sudhu-joshi/audio-amp/README.md

# Audio Amplifier Design
This is Project-1 of the EW-2 (EC2.202), Spring 2025. The design goes over theoretical calculation *(included in report)*, simulation and implementation of 4 stages:
# Stages
- Differential Amplifier
- CE Stage
- Active Bandpass Filter (20Hz-20kHz)
- Power Amplifier
# Report
All details related to the project are included in `amplifier_report`. Components used are included in the corresponding folder.
