sudhu-joshi/audio-amp/amp_report.pdf

# EW-2 Report Project 1: Audio Amplifier

Roshan Kondabattini
2023102061

Sudhanva Joshi
2023102022

10th January 2025

Note: All project files are saved in the github repository. (https://github.com/sudhu-joshi/audio-amp)

## Aim & Objectives

## 1 Differential Amplifier- Pre-Gain Stage

Considering we have a maximum input of 10 mV amplitude, with VCC = ±5V , we can get a maximum output voltage of 10 mV × 500 = 5V . Hence, we aim for a gain of 500. The stage gains must be split as follows:

- Given the information that the CE Amplifier works for small signals, we aim to pass a signal ≤ 100 mV .
- In order to amplify a 10 mV signal to 100 mV, we need a gain of 10 in the differential amplifier.

Basic Operation

- Amplifies the difference between two input signals Vin1 and Vin2.
- Comprises two matched BJTs (Q1 and Q2) sharing a common emitter via a constant current source.
- Output: Voltage difference between collector resistors (RC ).

Working Principle

- If Vin1 > Vin2: Q1 conducts more current, Q2 less. This creates a voltage difference at the collectors.
- If Vin2 > Vin1: Q2 conducts more current, Q1 less.
- If Vin1 = Vin2 (common-mode input): Both transistors share the current equally, resulting in no differential output.

Noise Cancellation

Noise often affects both inputs similarly as a common-mode signal. The differential amplifier rejects this common-mode noise. It responds only to the difference between the inputs, effectively canceling the noise and amplifying the difference.

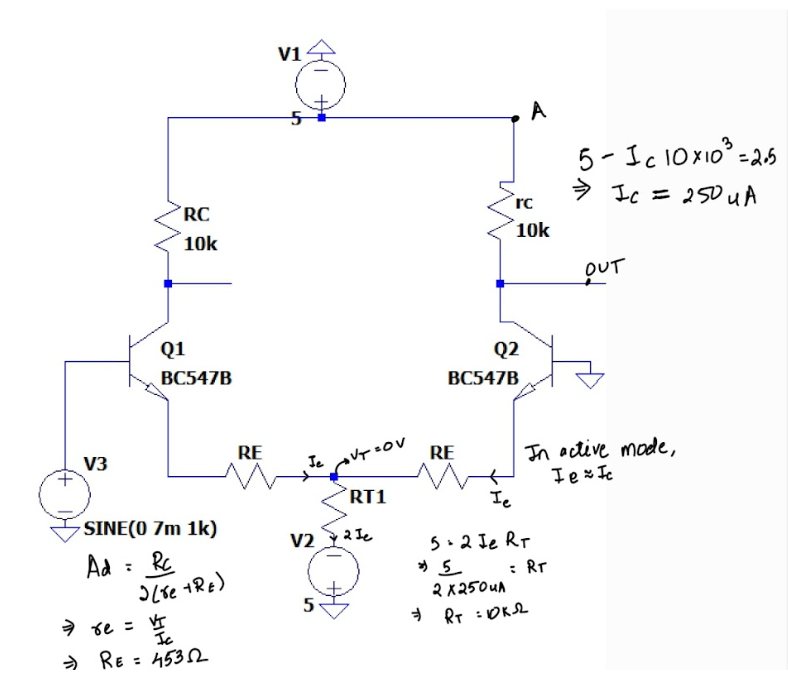
[picture p1: figure]

Figure 1: Rough Calculation, Differential Amplifier

Gain derivation of Differential Amplifier

iC1(AC + DC) = I
2

+ ∆ic

=

I
2

+ ic (AC)

=

I
2

+ gm (Vi2)

=

I
2

+ gm (−Vid)

=

I
2

−

gmVid
2

vout = VCC − IAC+DC RC (AC only taken)

= VCC −

I
2

RC +

gmVidRC
2

Vout (differential)

Vin

=

gmVidRC
2Vid

=

gmRC
2

Gain = RC
2(re + RE)

where an external Re is added with re.

Parameter Calculations

As we work with ±5 V, we make a few initial assumptions (these shall be substantiated by our calculations).
VT = 0V

IC ≈ IE (Active BJT s)

RC = 10k Ω

To calculate IC , we simplify the following Voltage Equation:

Vcc − R2 · IC = 2.5V

IC · 10k = (2.5 − 5) · (−1)

IC = 2.5 · 10⁻⁴

∴ IC = 250µA

As IC is symmetric between both Emitter Branches,

IT = 2 · IC

Using Ohm’s Law (V = I· R):
5 = 2 · IC

5 = 5 · 10⁻⁴
- Rtail

∴ Rtail = 10k Ω

To account for Non-Ideal Conditions, we assume a gain G1 = 11

Ad =

RC
2 · (re + RE)

Ad =

RC
2 · (re + RE)

re =

VT
IC
Substituting VT = 26mV & IC = 2.5 · 10⁻⁴ :

re = 104 Ω

Solving for RE:

11 =

10 · 10³
104 + RE
∴ RE = 453 Ω

To account for our assumption of G1 = 11, RE = 453 Ω is considered as a starting value, after which it is lowered until the appropriate gain is achieved.
In conclusion, we arrive at R = 354 Ω for the desired gain specification, i.e. G1 ≈ 10.

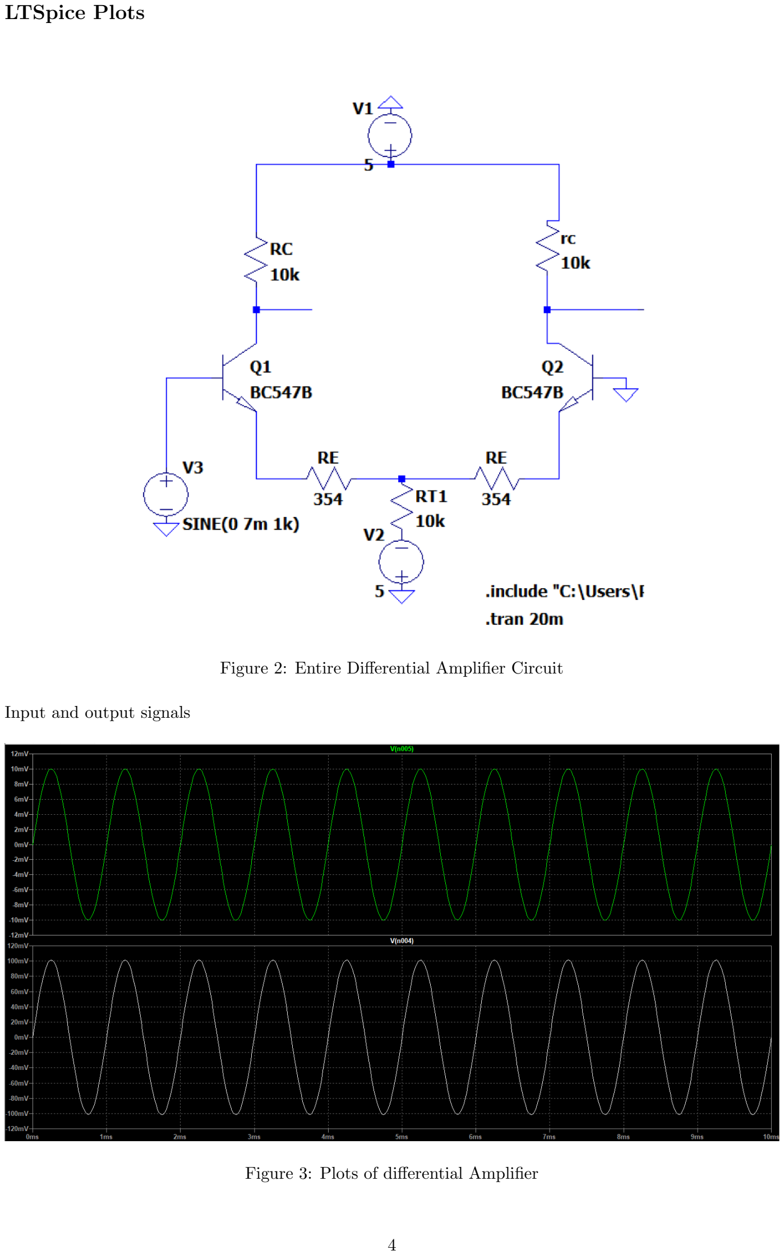
[picture p2: page 4]

LTSpice Plots

Figure 2: Entire Differential Amplifier Circuit

Input and output signals

Figure 3: Plots of differential Amplifier

CMRR, Input & Output Resistances

- Common Mode Rejection Ratio is the ability of a differential amplifier to reject common-mode signals (signals present equally on both inputs) while amplifying differential signals (difference between inputs).
- High CMRR indicates better noise rejection and improved signal fidelity.

CMRR = 20 · log(

Ad
Ac

)

Calculating AC , we give 10mV to both BJTs of our differential amplifier, we get the following gain:

Ac = 0.5

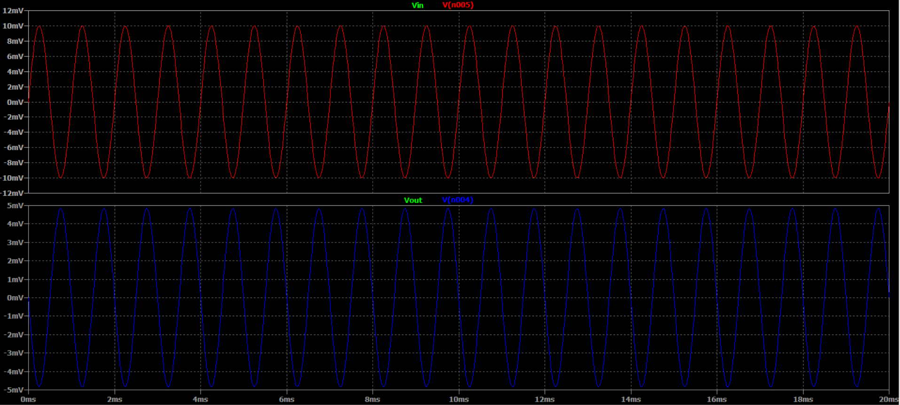
[picture p3: figure]

Figure 4: AC Relation; Vin & Vout

Substituting Gains to get CMRR:

CMRR = 20 · log(

10
0.5

)

∴ CMRR ≈ 26

Input Resistance Grounding output and giving VDC = 1V , we get current of 57µ A. Rin = 17543 Ω.

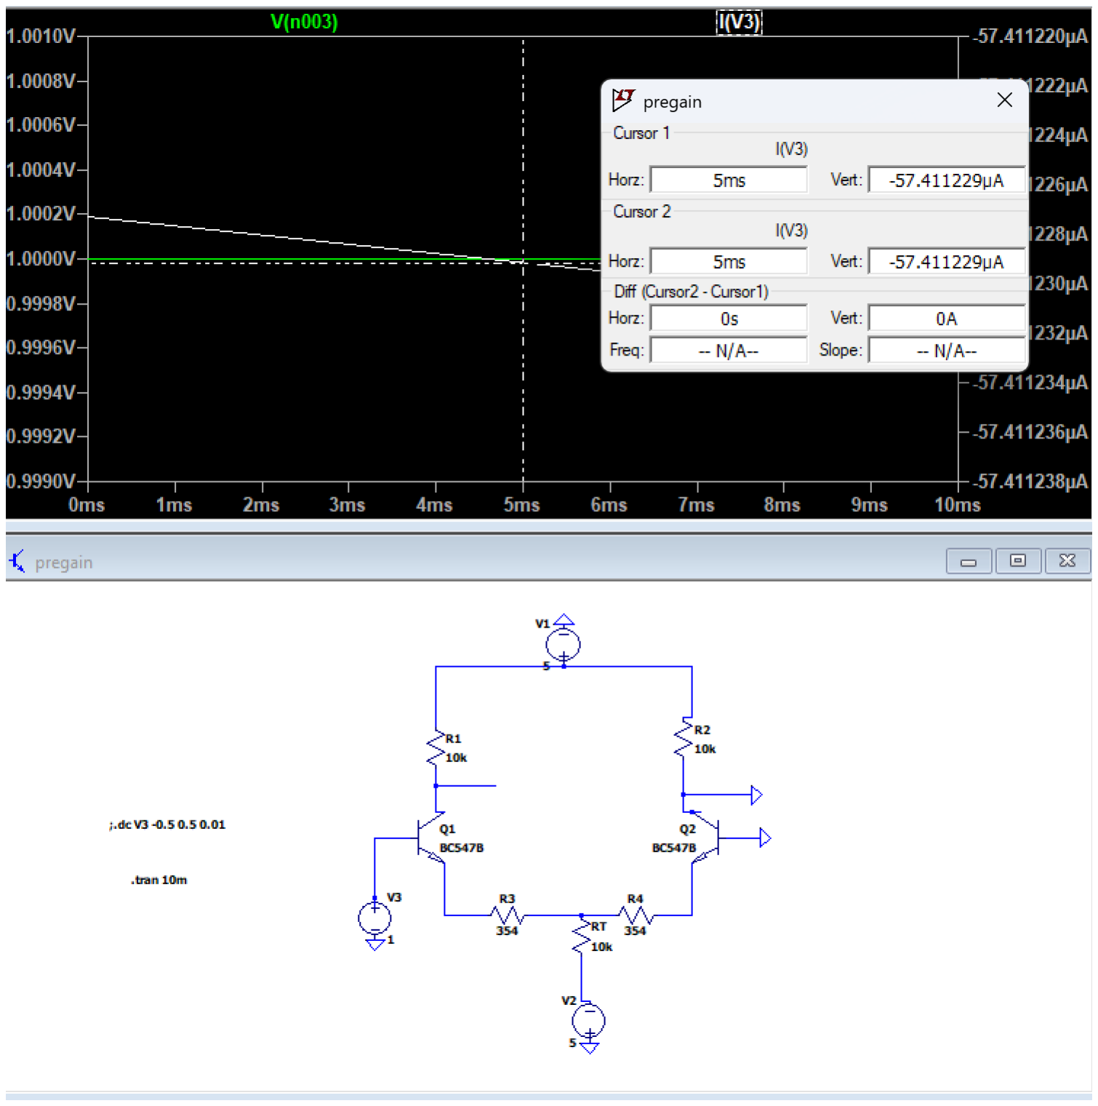
[picture p4: figure]

Figure 5: Rin

Output resistance We give output voltage 1V, and ground the input, we have resistance of 5kΩ.

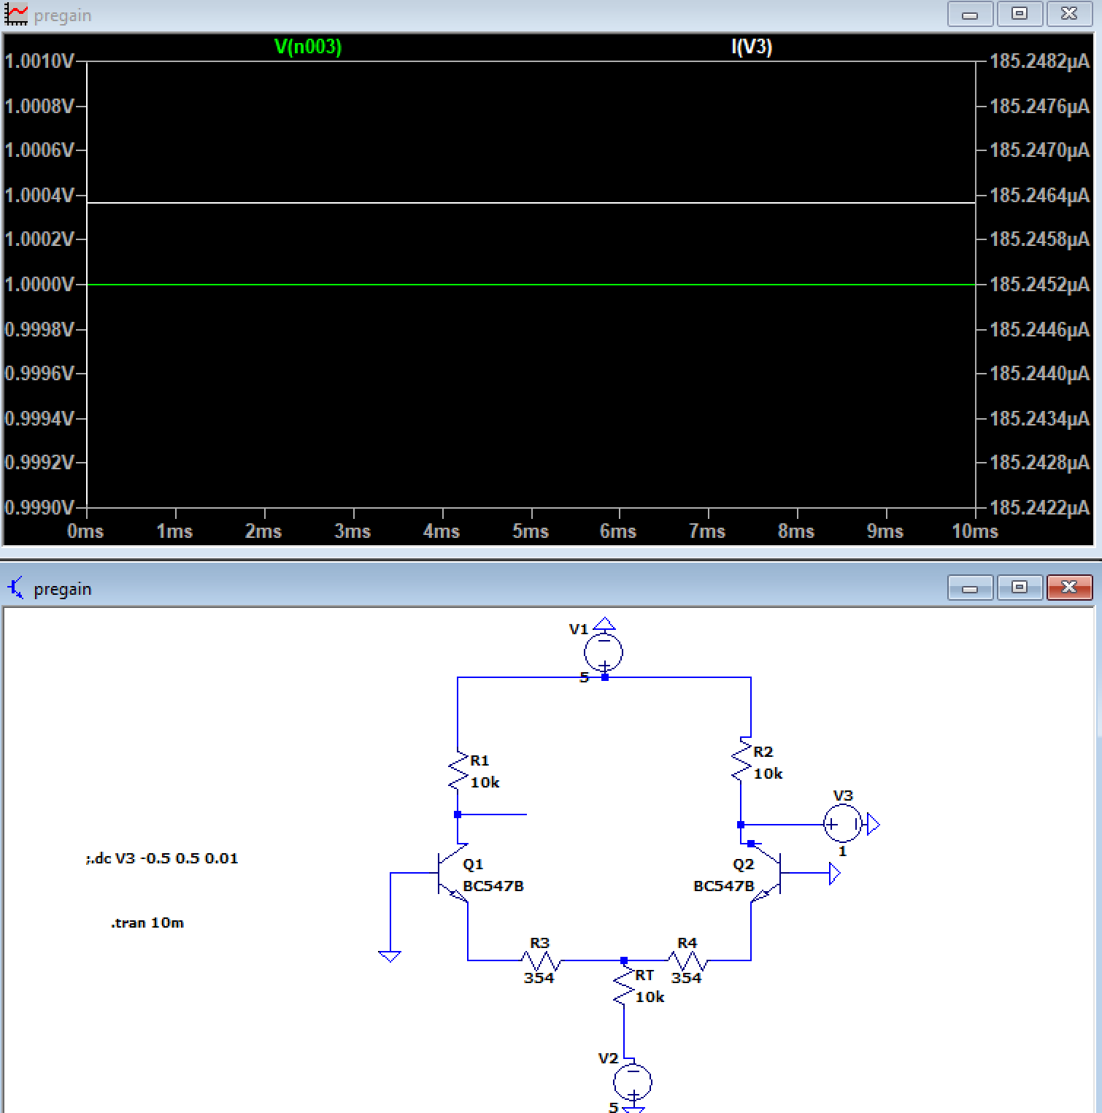
[picture p5: figure]

Figure 6: Ouput Resistance

## 2 Common Emitter (CE) Amplifier

- Purpose: Provides voltage amplification with phase inversion.
- Configuration: Input is applied at the base, output is taken from the collector, and the emitter is connected to ground through a resistor.
- Key Features: High voltage gain, moderate input impedance, low output impedance, and an inverted output signal.
- Working Principle:

– Small increases in base-emitter voltage (VBE) (a few mV) significantly increase base current (IB).

– Current gain (β) amplifies IB, causing larger changes in collector current (IC ).

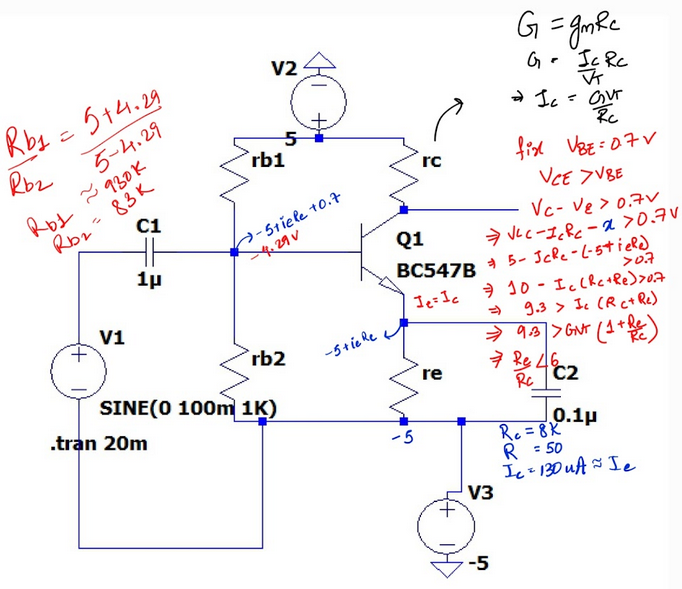
[picture p6: figure]

Figure 7: Parameter Calculations, CE Amplifier

Gain derviation of CE amplifier

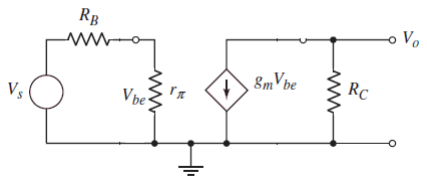
[picture p7: figure]

Figure 8: Small signal model of CE amplifer

form the above figure, We start with Ohm’s Law:

V = IR

For the output voltage:

Vout = gmVbe(RC ∥ RL)

The voltage gain is given by:

Vout

Vin

= gmRC

where we assume RL = 0.

Parameter Calculations

For a CE amplifier,we fix G=60 and calculate the values.

G = gm · RC

gm =

IC
VT

IC =

G · VT
RC

F ixing VBE = 0.7V

VC − VE > 0.7V

VCC − IC · RC − x > 0.7V

W here x = −5 + IE · RE

10 − IC · (RC + RE) > 0.7V

∴ G · VT (1 + RE
RC

) < 9.3

Substituting values, we get: RE
RC

< 6

To ensure active BJTs, we calculate Rb1 & Rb2 using Current Law as follows, with VB = −4.29V

Rb1

Rb2

=

5 + 4.29
5 − 4.29

∴ Rb1 ≈ 930k Ω, Rb2 ≈ 78k Ω

Our final values are:
RC = 8k Ω

R = 50 Ω

IC ≈ IE = 130 µA

LTSpice Plots

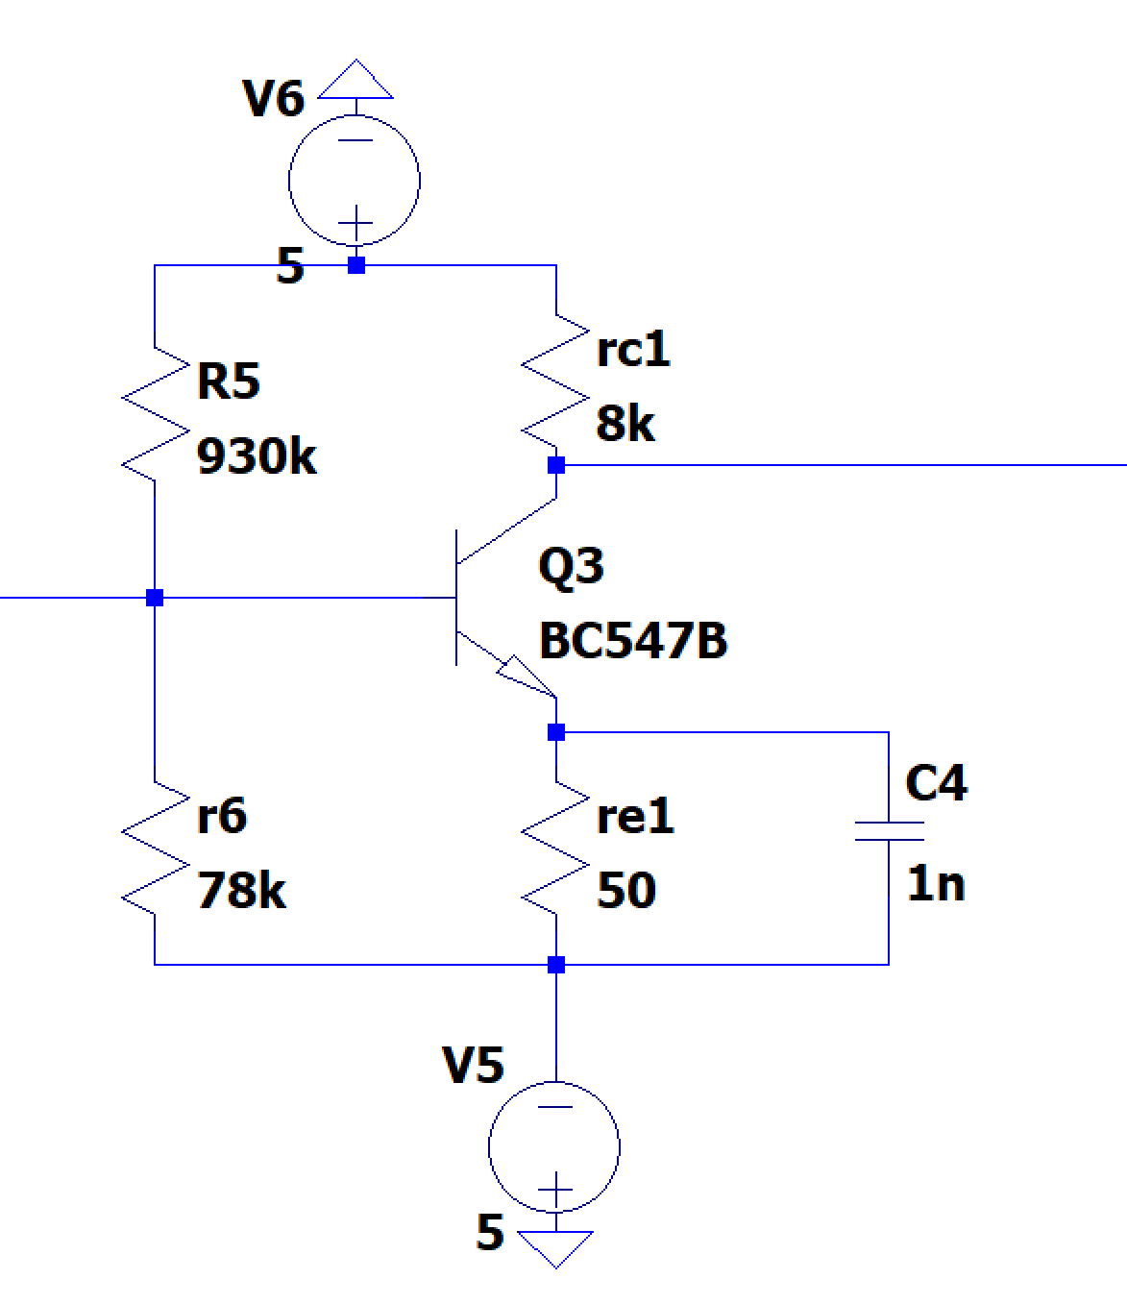
[picture p8: figure]

Figure 9: LTSpice CE amplifier

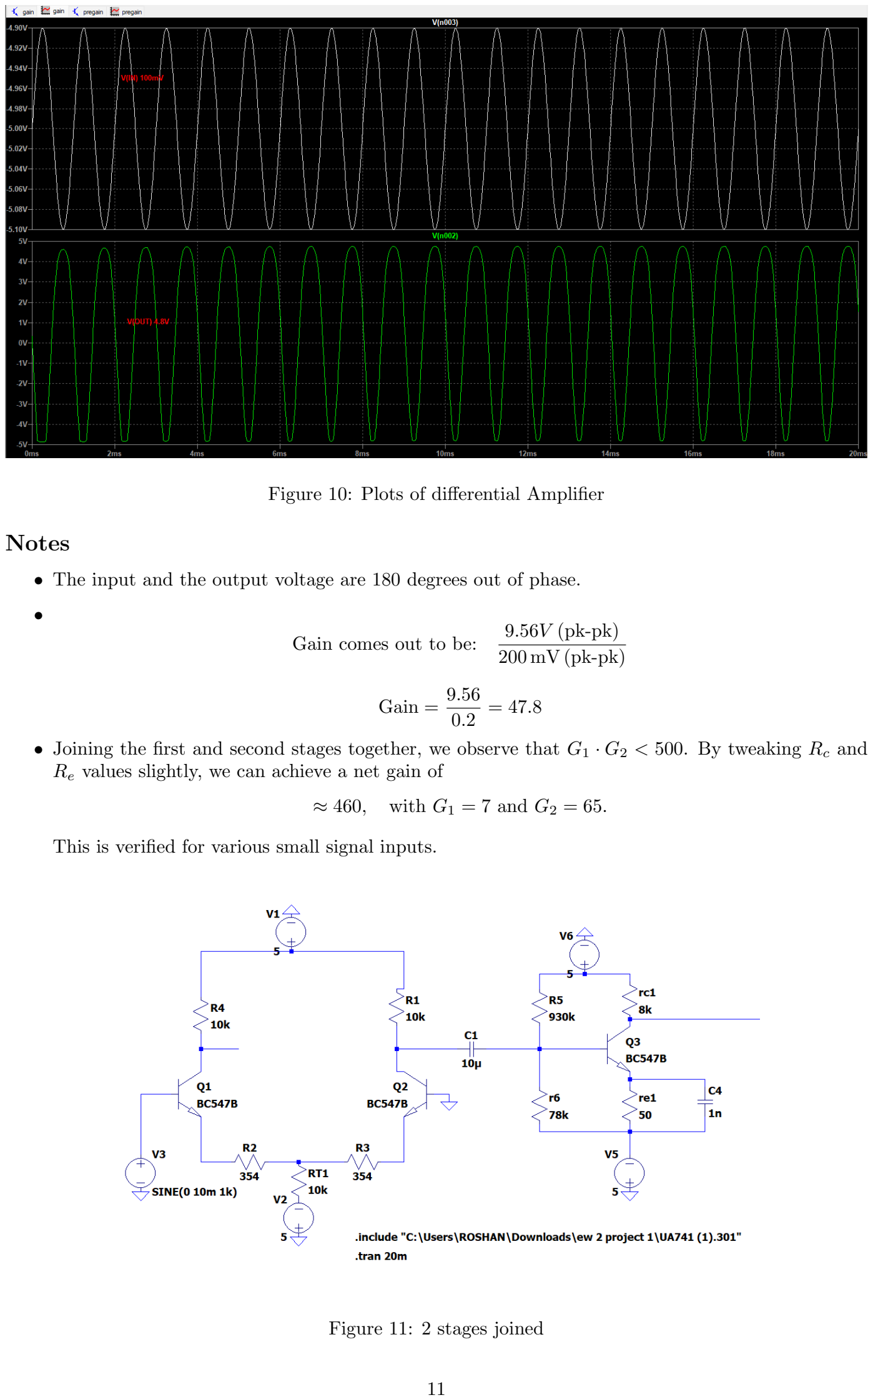
[picture p9: page 11]

Figure 10: Plots of differential Amplifier

Notes

- The input and the output voltage are 180 degrees out of phase.
•
Gain comes out to be: 9.56V (pk-pk) 200 mV (pk-pk)

Gain = 9.56
0.2

= 47.8

- Joining the first and second stages together, we observe that G1 · G2 < 500. By tweaking Rc and Re values slightly, we can achieve a net gain of

≈ 460, with G1 = 7 and G2 = 65.

This is verified for various small signal inputs.

Figure 11: 2 stages joined

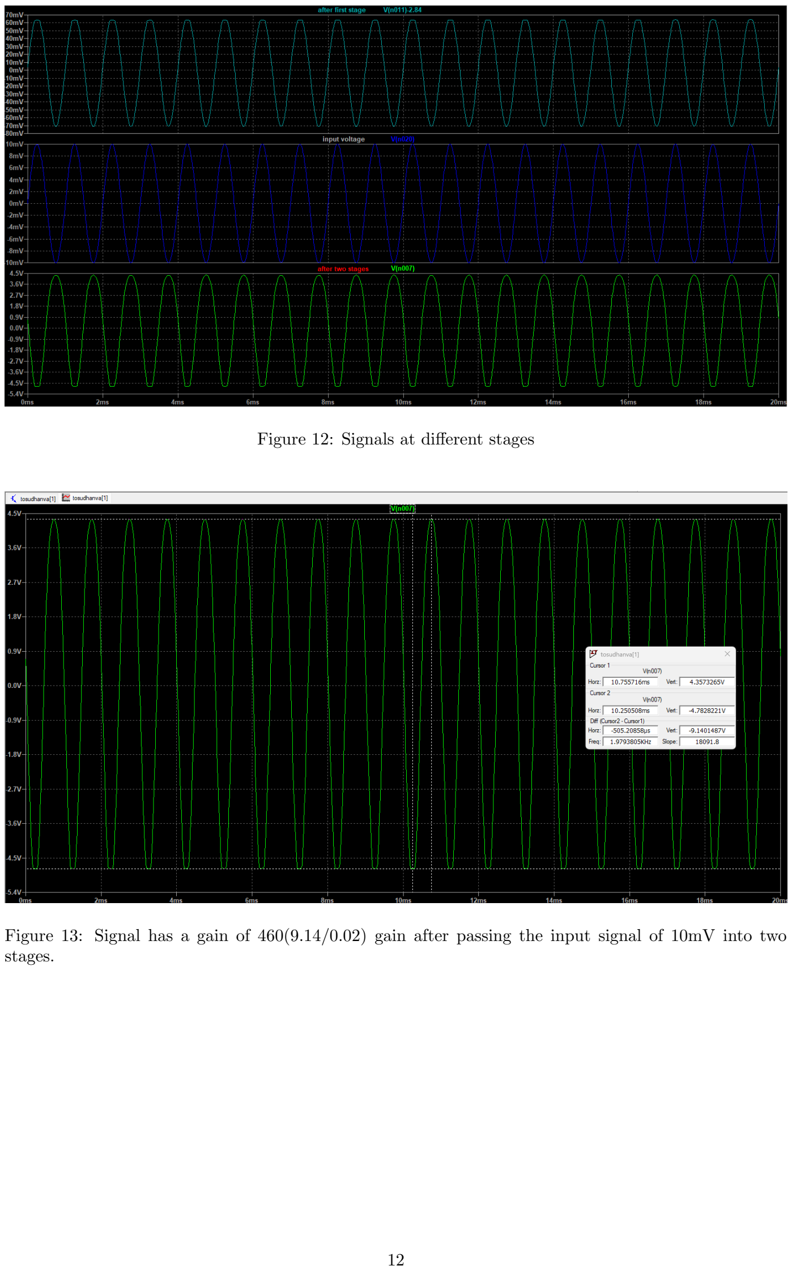
[picture p10: page 12]

Figure 12: Signals at different stages

Figure 13: Signal has a gain of 460(9.14/0.02) gain after passing the input signal of 10mV into two stages.

## Bandpass filter

We use a filter stage to eliminate freq. components other than 20Hz-kHz.
We make an active bandpass filter by connecting an HPF and an LPF with voltage followers in between.A active filter is a filter that has a voltage supply to it.

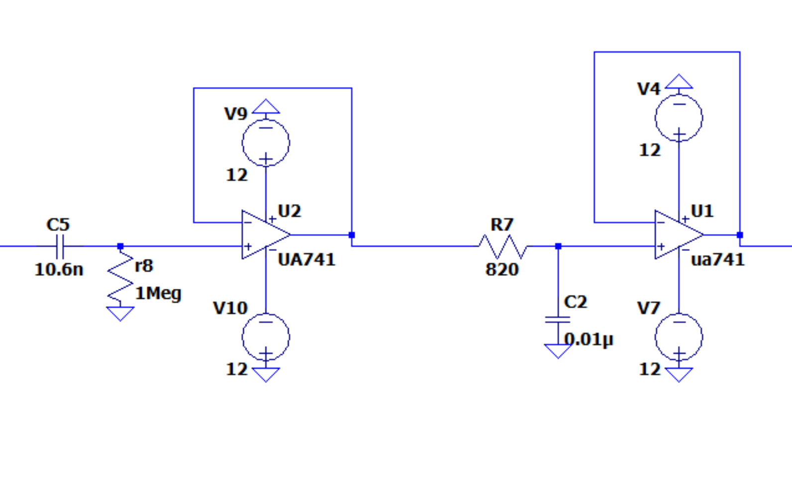
[picture p11: figure]

Figure 14: Bandpass is a combination of a lowpass and a highpass

High-Pass Filter (HPF):
The cutoff frequency for the HPF is given by:

fHPF =

1
2πR1C1

Substituting R1 = 1 MΩ and C1 = 8 nF:

fHPF =

1
2π(1 × 10⁶)(10.6 × 10⁻⁹)

≈ 20 Hz

we have taken a high-value resistance so that the loading effects to the CE amplifier [ Rc||Rl

] will be
approximated to RC .
Low-Pass Filter (LPF): The cutoff frequency for the LPF is given by:

fLPF =

1
2πR1C1

Substituting R1 = 820 Ω and C1 = 0.01 µF:

fLPF =

1
2π(820)(1 × 10⁻⁸)

≈ 20 kHz

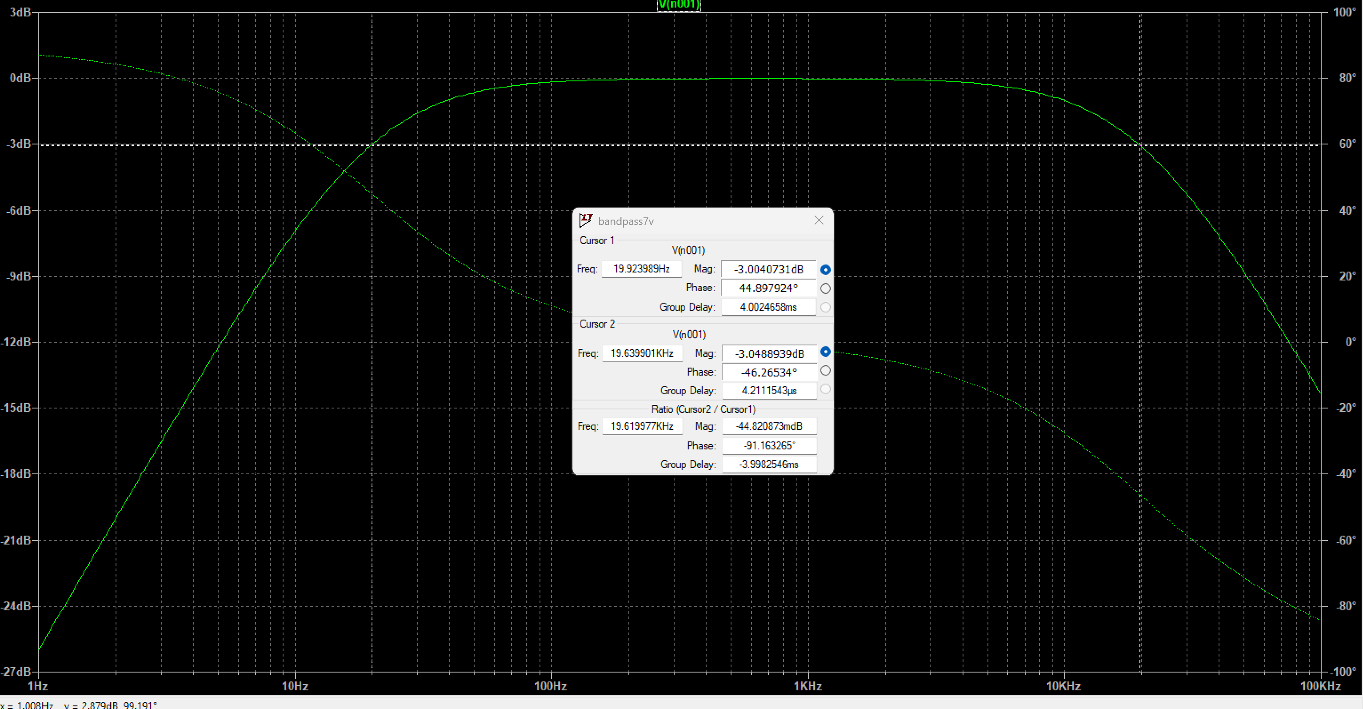
[picture p12: figure]

Figure 15: AC analysis of bandpass filter

Note:
There is a −3 dB gain at approximately 15 Hz and 20 kHz.

## Power Amplifiers

Power amplifiers are designed to deliver significant power to a load (e.g., a speaker) and operate efficiently at high output levels. They are typically used in the final stages of amplification in audio systems.

Class AB Design

- Combines the efficiency of Class B amplifiers with the low distortion of Class A amplifiers.
- Operates with both transistors conducting slightly during the crossover point, reducing crossover distortion.
- Biasing Using Diodes

– Diodes are used to set the biasing voltage for transistors in the Class AB amplifier.

– Typically, two diodes are placed in series with the base-emitter junctions of the output transistors.

– The forward voltage drop of the diodes ensures a small quiescent current through the transistors, minimizing crossover distortion.

Vbias = 2Vf (where Vf is the forward voltage of each diode).

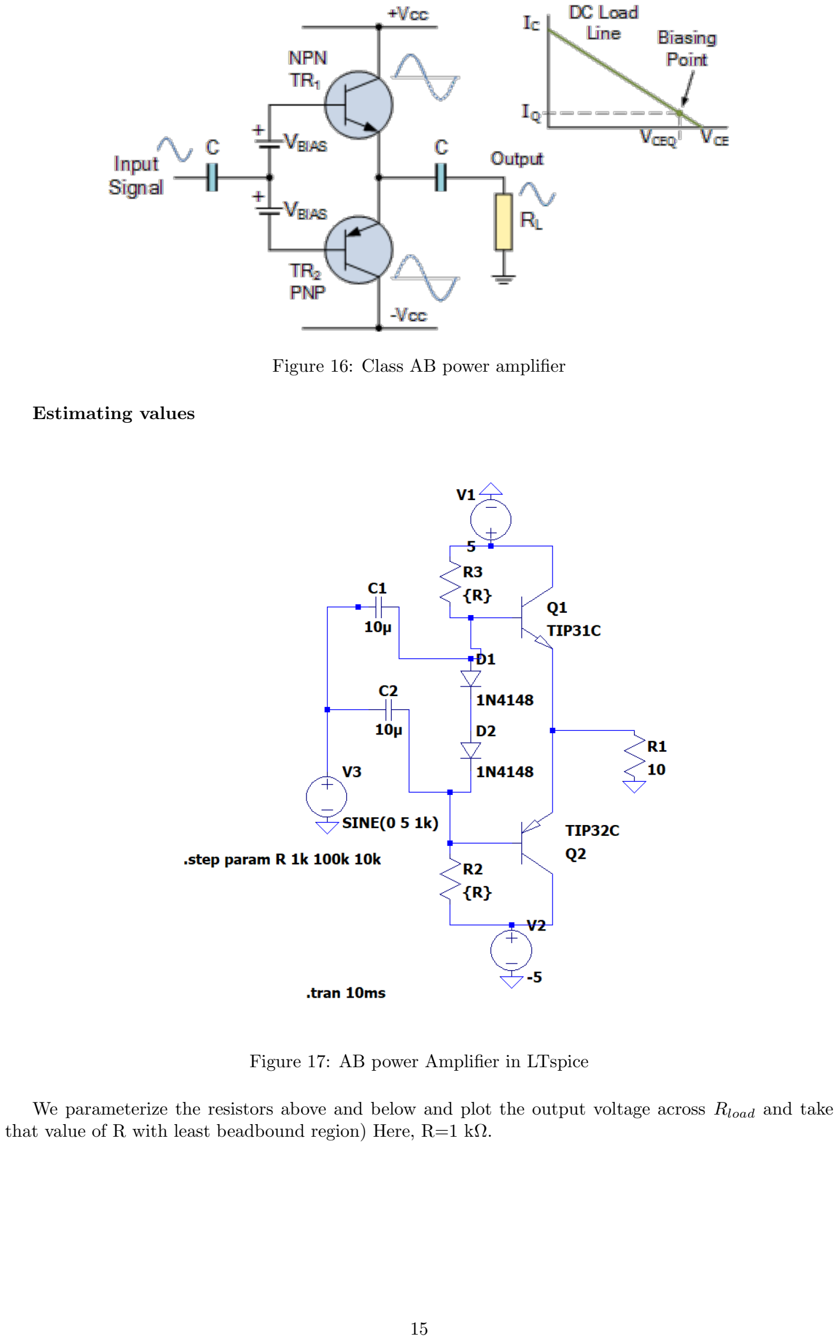
[picture p13: page 15]

Figure 16: Class AB power amplifier

Estimating values

Figure 17: AB power Amplifier in LTspice

We parameterize the resistors above and below and plot the output voltage across Rload and take that value of R with least beadbound region) Here, R=1 kΩ.

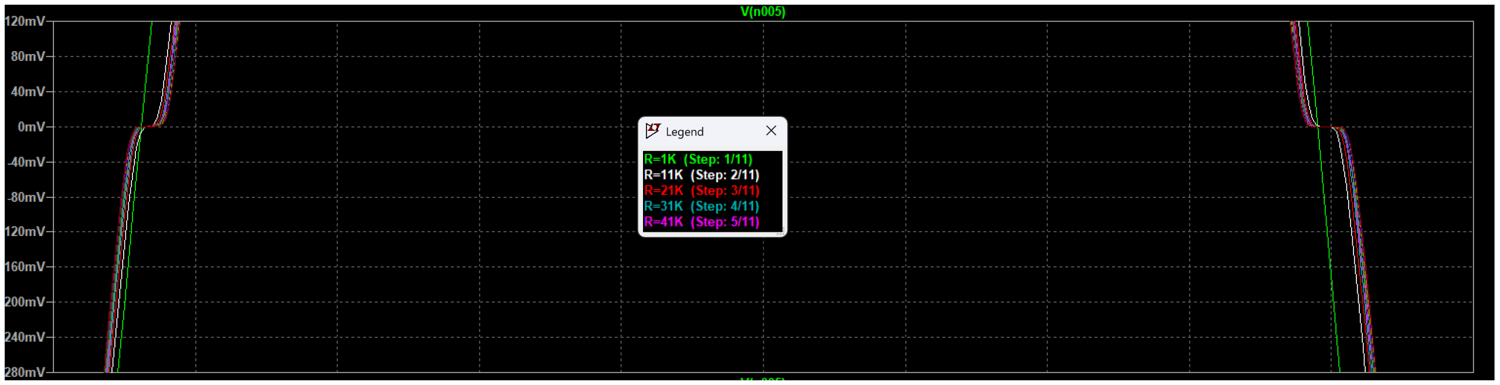
[picture p14: figure]

Figure 18: Analyzing output for various resistances

There will be a potential drop in output accounting for VBE.

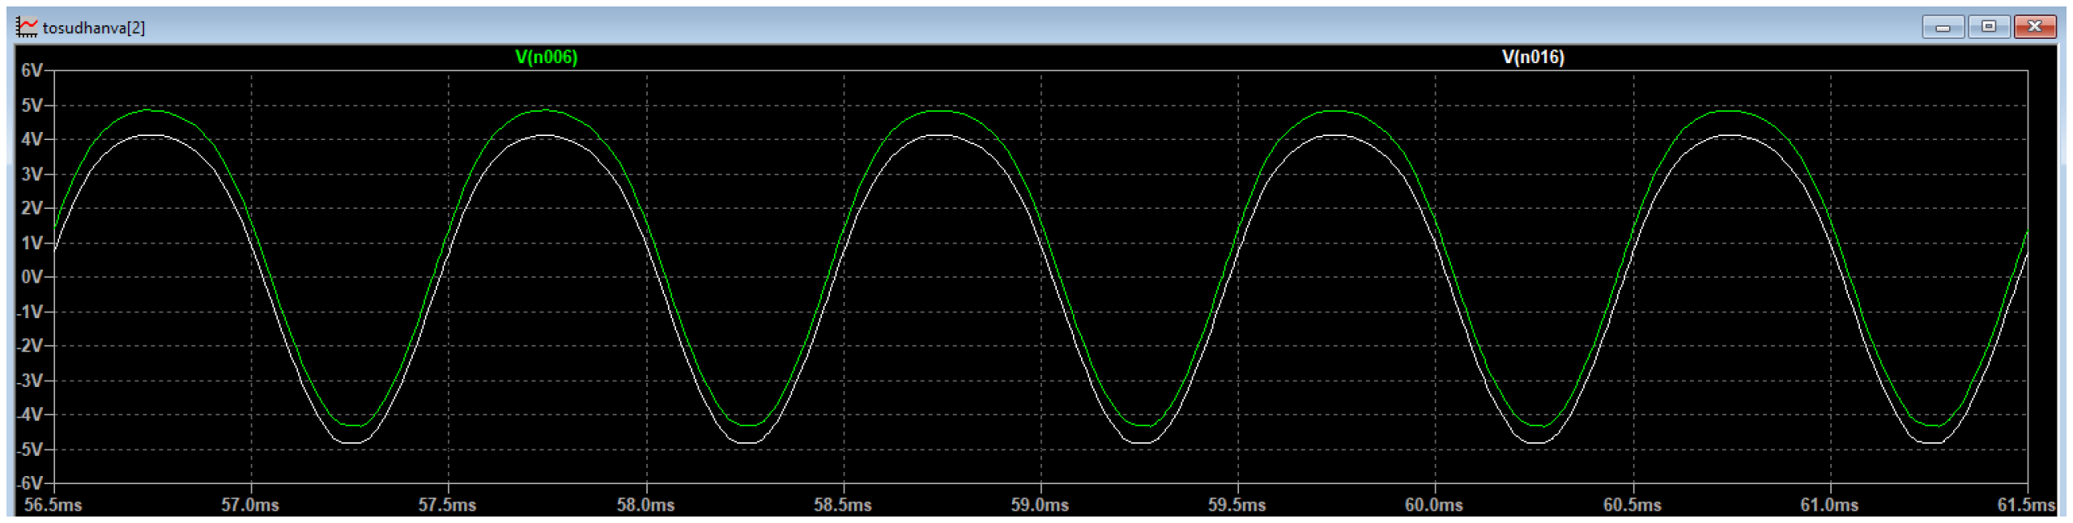
[picture p15: figure]

Figure 19: The positive half cycle has a voltage drop and negative half cycle has a increase in neagtive sense

Power Calculation

Given:

- Peak Current (Imax) = 0.45 A
- Peak Voltage (Vmax) = 4.5 V

To calculate the power, we use the formula for the RMS values derived from the peak values:

Vrms =

Vmax √
2

, Irms =

Imax √
2

Then, the power P is given by:

P = Vrms · Irms =

Vmax · Imax
2

Substituting the values:

P =

4.5 · 0.45
2

= 1.025W

Thus, the power is P = 1.025W.

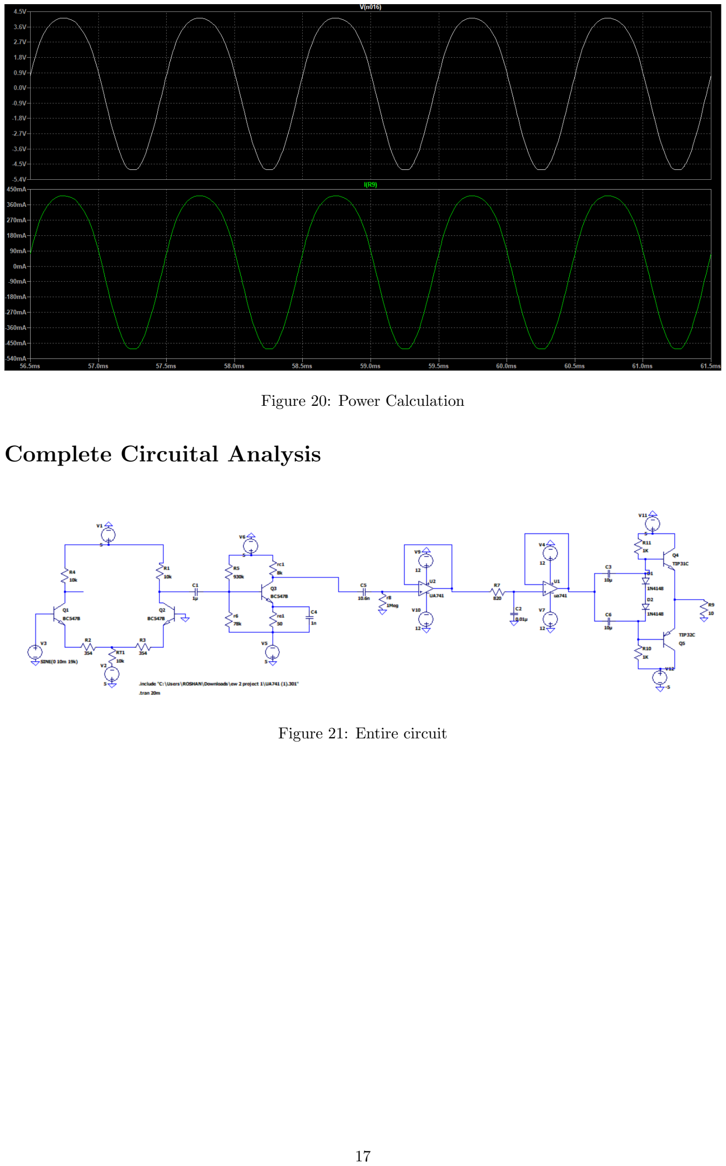
[picture p16: page 17]

Figure 20: Power Calculation

## Complete Circuital Analysis

Figure 21: Entire circuit

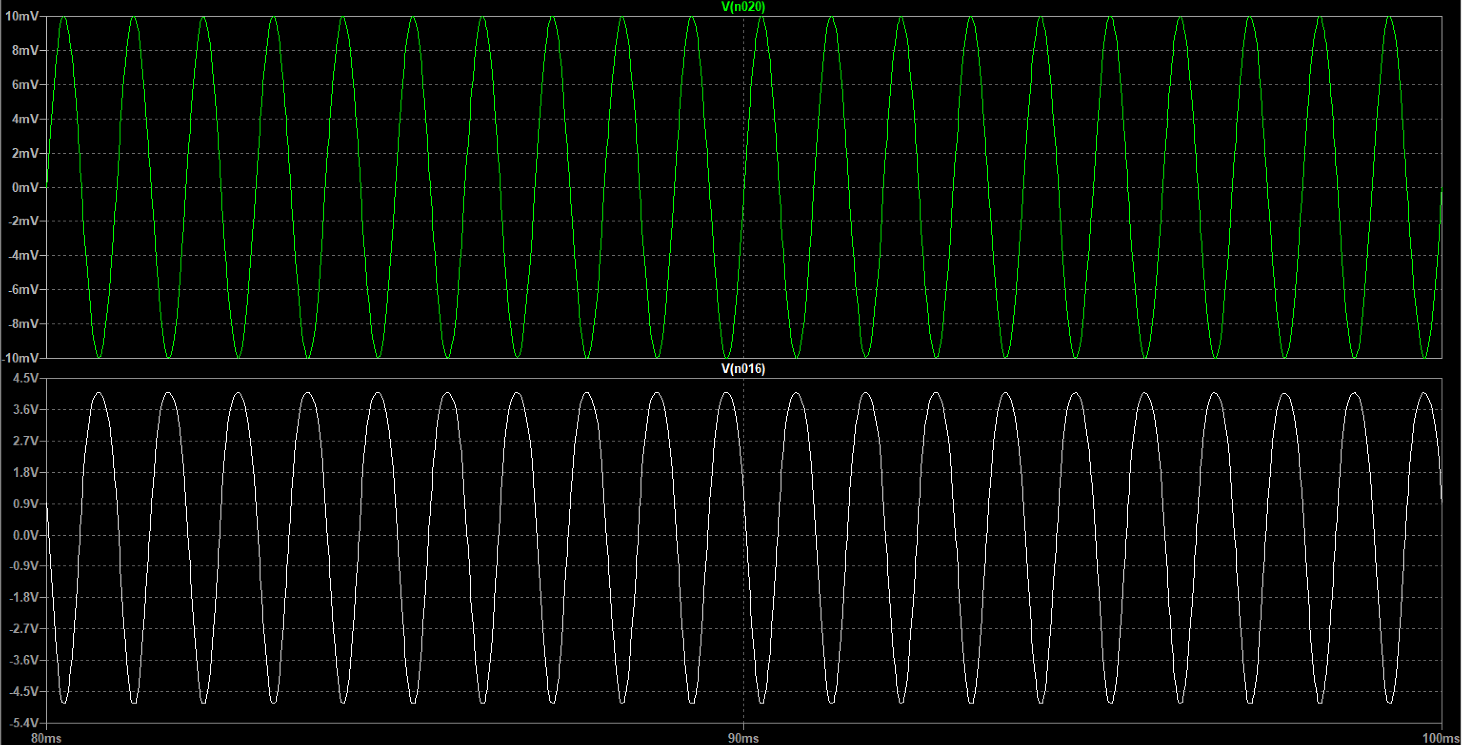
[picture p17: figure]

Figure 22: Vin & Vout

Total Harmonic Distortion

A Total Harmonic Distortion (THD) audio amplifier is designed to amplify an audio signal while minimizing unwanted distortions. THD refers to the harmonic components that are added to the original signal due to imperfections in the amplifier’s circuitry. It is defined as follows:

T HD =

qP∞
n=2 V ²
n,rms

Vf rms

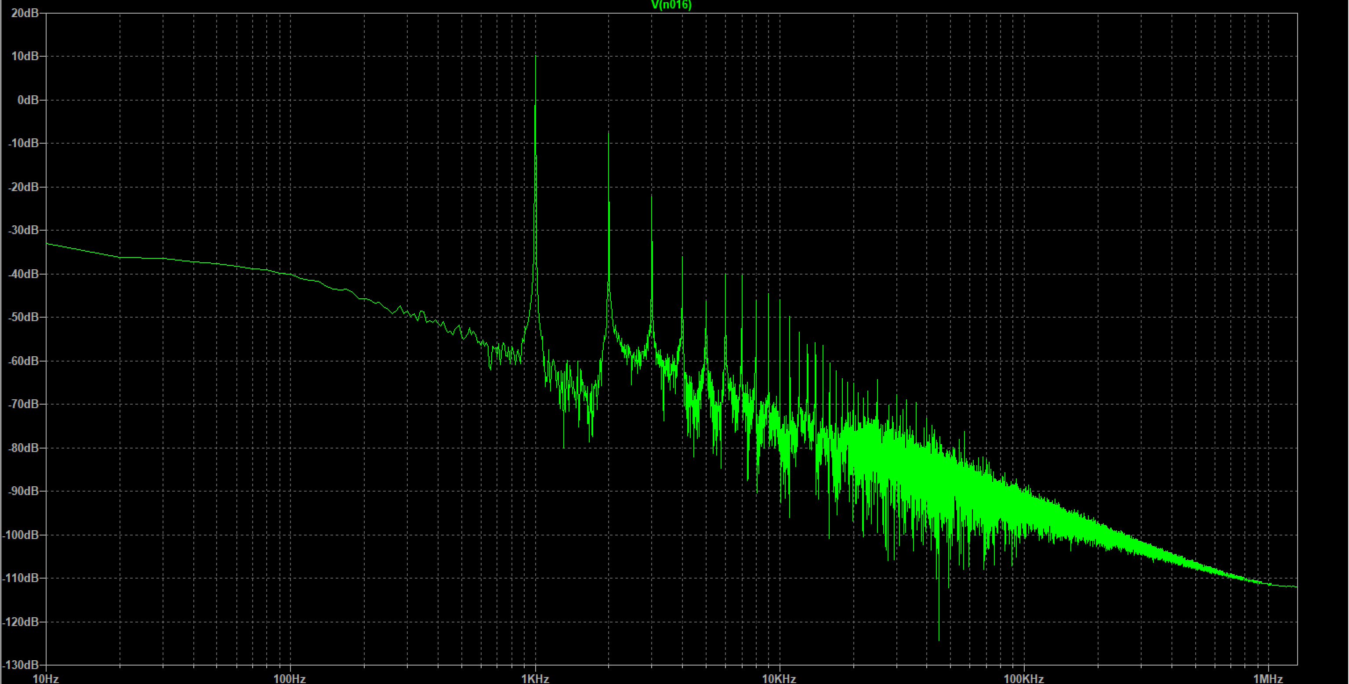
[picture p18: figure]

Figure 23: FFT, Output Wave

After applying FFT to our Output Wave, we consider the first five harmonics as a reasonable estimate.

Frequency(Hz) | Voltage(RMS)
1kHz | 3.26V
2kHz | 0.417V
3kHz | 0.076V
4kHz | 0.015V
5kHz | 0.003V

Table 1: Harmonic Values

We get our final THD reading by substituting the observations as follows:

∴ T HD ≈ 0.1301

Slew rate

Slew Rate refers to the rate at which the output voltage of an amplifier changes over time. It is typically measured in volts per microsecond (V/us) and is an important parameter for audio amplifiers, as it determines how quickly the amplifier can respond to rapid changes in the input signal. S.R. = max(

δVout
δt )
From LTSpice, by plotting δVout
δt , it has a maximum Slew Rate ≈ 0.35 V/µs.

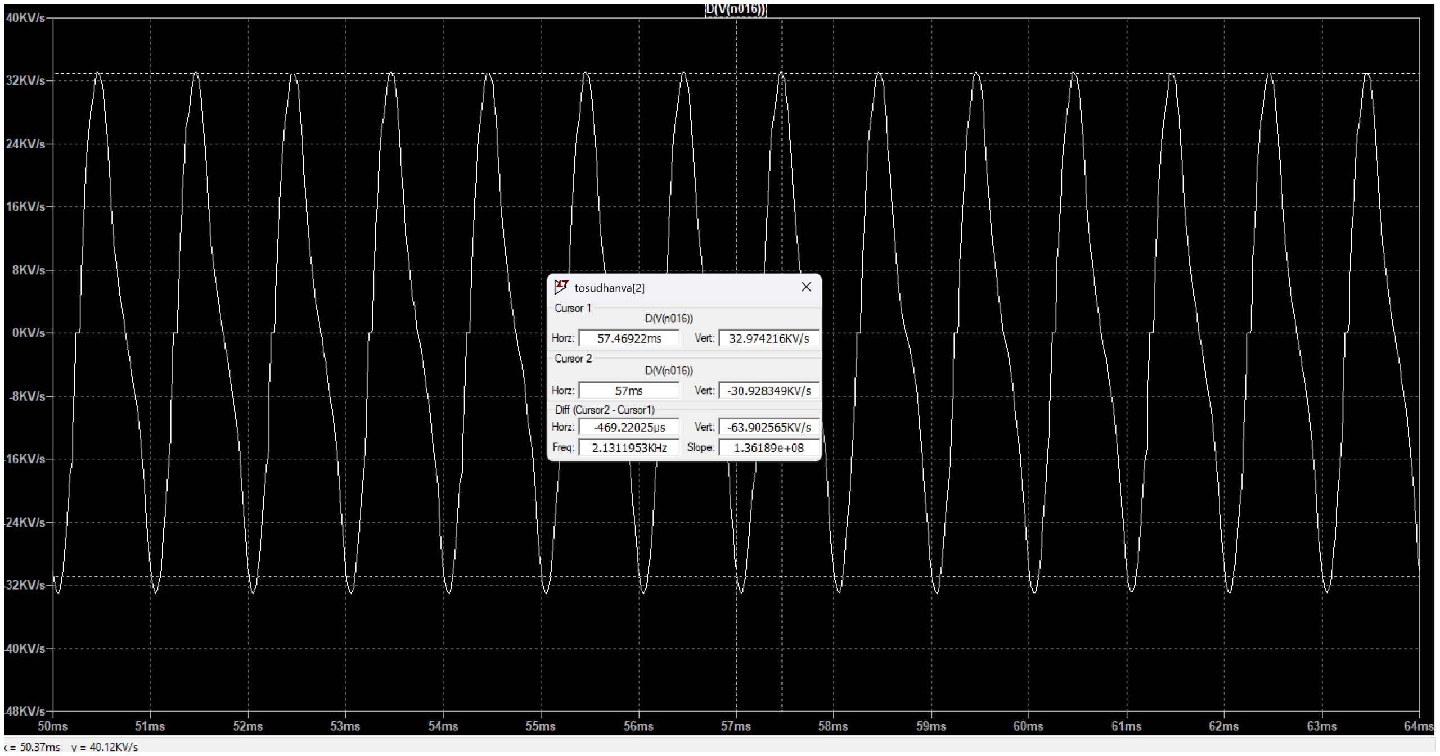
[picture p19: figure]

Figure 24: Slew rate

## Hardware Observations

The hardware implementation employs a few practical changes in component values that detract from our original simulation to account for non-idealities.

- (Input/Output Impedances, Heat etc) necessitate adjustmenets in resistance and capacitance values being used in all stages.
- The Frequency Response of bandpass stage requires the cutoff frequencies (20Hz-20kHz) to be at 0dB gain; The true -3dB cutoffs must considered further away from our initially calculated values for fc.

Readings with the final circuit are given below.

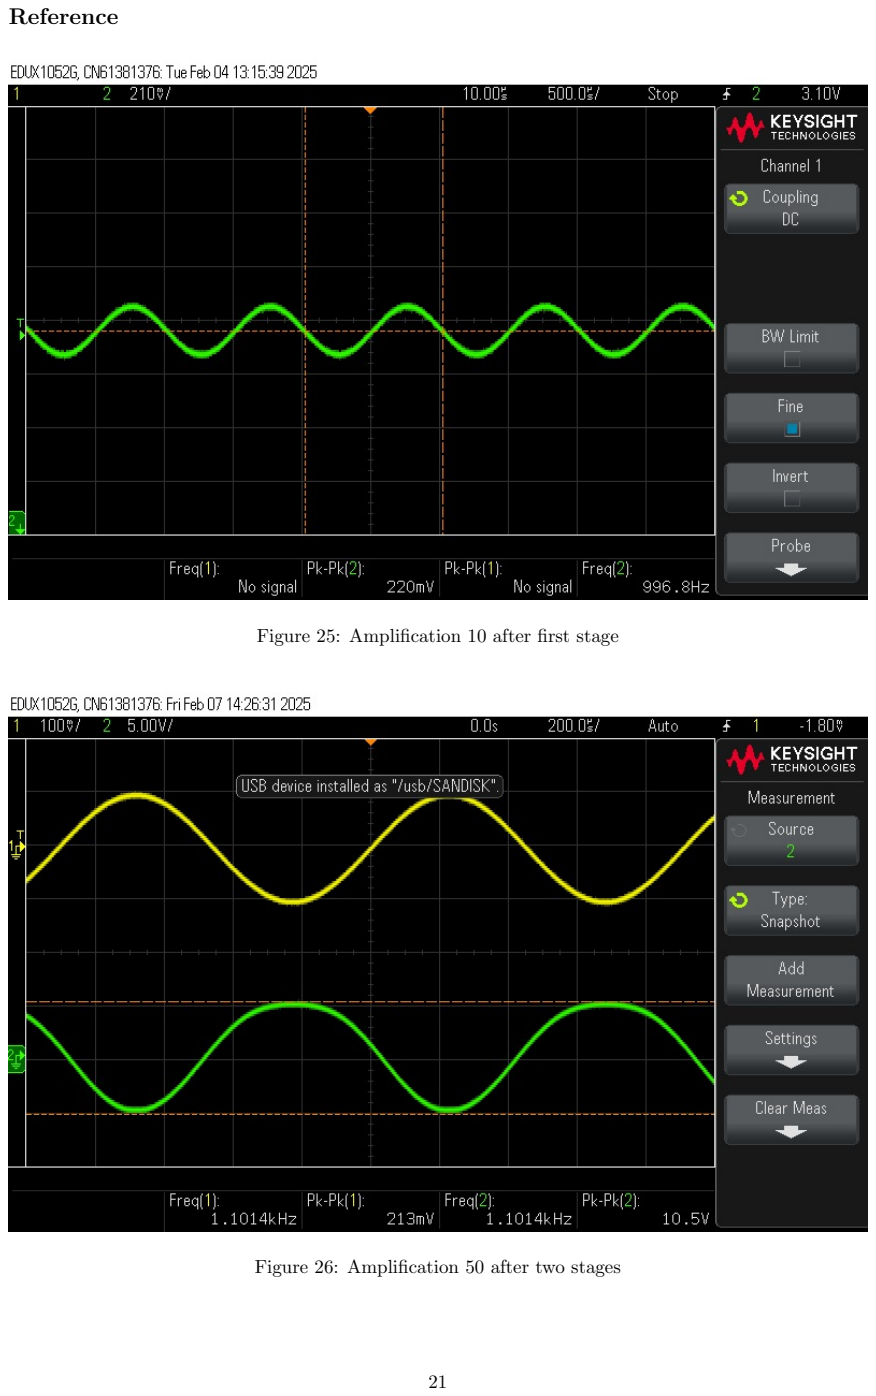
[picture p20: page 21]

Reference

Figure 25: Amplification 10 after first stage

Figure 26: Amplification 50 after two stages

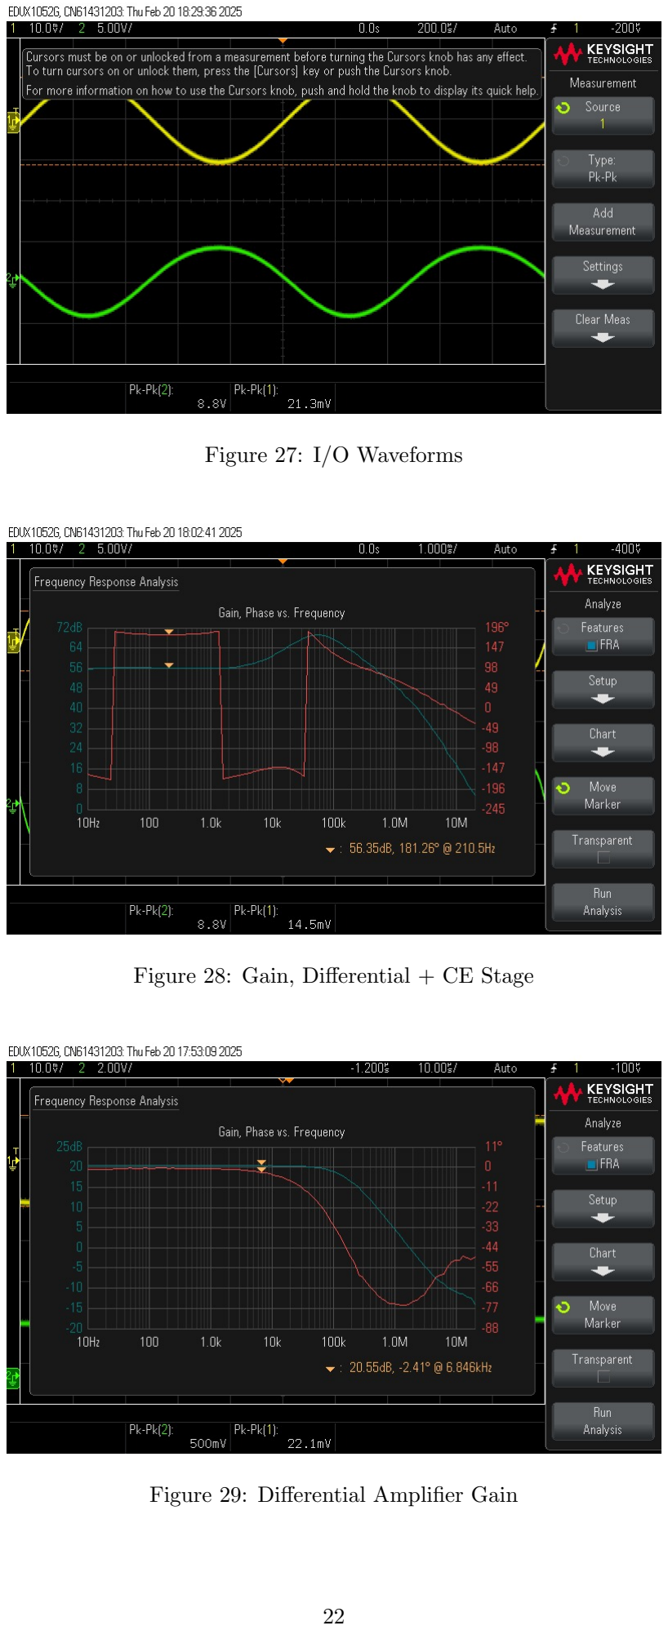
[picture p21: page 22]

Figure 27: I/O Waveforms

Figure 28: Gain, Differential + CE Stage

Figure 29: Differential Amplifier Gain

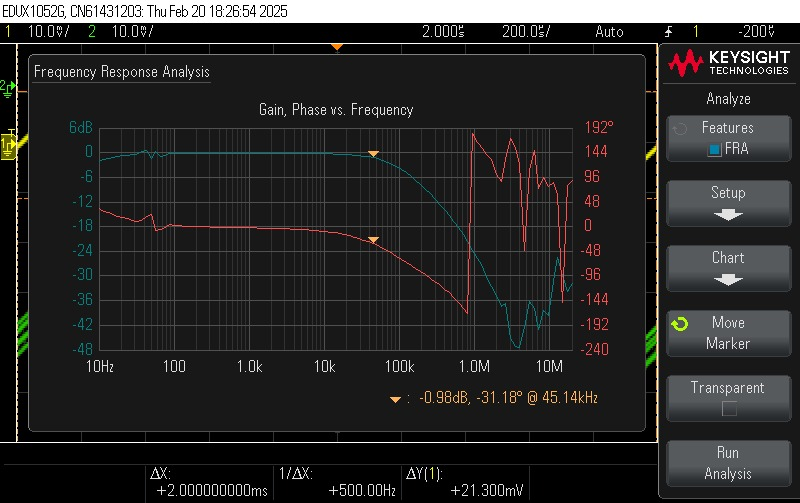
[picture p22: figure]

Figure 30: Frequency Analysis, Bandpass Filter

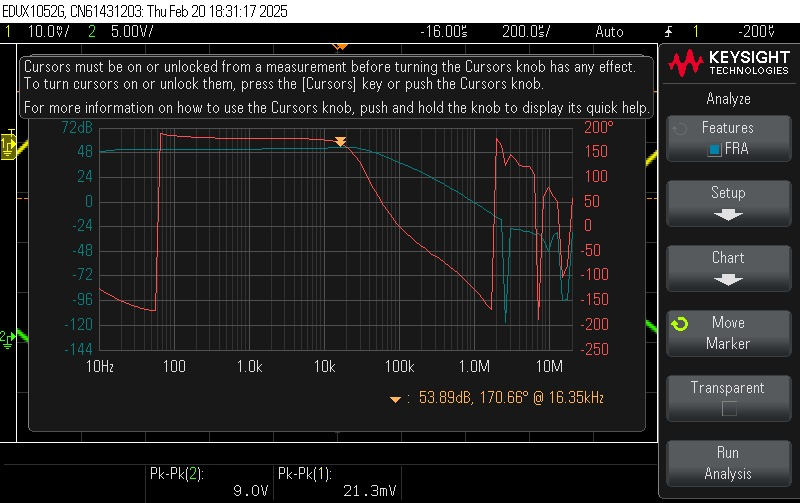
[picture p23: figure]

Figure 31: Final Circuit, 4 Stages Attached (Observe Reduced Gain)

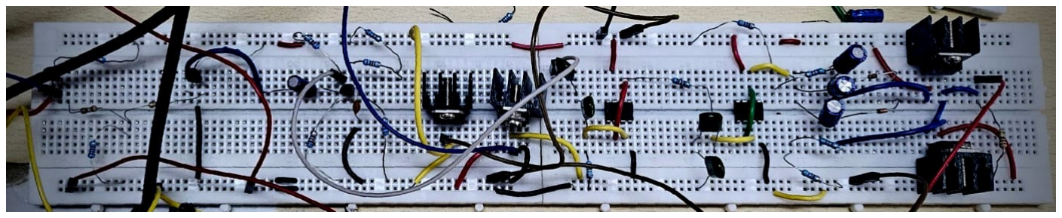
[picture p24: figure]

Figure 32: Breadboard Implementation

The following link (https://drive.google.com/drive/folders/1P2cuS2pisJTLGYLteeh7LIbMl3ZVDobP?usp=drive_link) showcases the practical exhibition of our amplifier.

## Acknowledgement

We would like to sincerely thank the professors, TAs and lab assistants for their unending support and guidance throughout the course of this project. section*References

- YouTube Playlist 1 (https://www.youtube.com/playlist?list=PLZvLSclgk4yJRrbA5jOTC45NUD1kkwjWQ)
- YouTube Playlist 2 (https://www.youtube.com/playlist?list=PLZvLSclgk4yJJOfzvvpE31Qg3bORzwQ0_)
