sudhu-joshi/audio-amp/simulations/bandpass.asc

C1: cap; 0.1µ
C2: cap; 10.6n
R1: res; 82
r4: res; 1Mega
U1: opamp2; UA741
U2: opamp2; ua741
V2: voltage; 1; AC 1
V3: voltage; 7
V4: voltage; 7
V5: voltage; 7
V6: voltage; 7
Named nets: 0
.include "specify_UA741.301_filepath"
.ac dec 80 1 100k
