sudhu-joshi/audio-amp/simulations/final_circuit.asc

C1: cap; 1µ
C2: cap; 0.01µ
C3: cap; 10µ
C4: cap; 1n
C5: cap; 10.6n
C6: cap; 10µ
D1: diode; 1N4148
D2: diode; 1N4148
Q1: npn; BC547B
Q2: npn; BC547B
Q3: npn; BC547B
Q4: npn; TIP31C
Q5: pnp; TIP32C
R1: res; 10k
R2: res; 354
R3: res; 354
R4: res; 10k
R5: res; 930k
r6: res; 78k
R7: res; 820
r8: res; 1Meg
R9: res; 10
R10: res; 1K
R11: res; 1K
rc1: res; 8k
re1: res; 50
RT1: res; 10k
U1: opamp2; ua741
U2: opamp2; UA741
V1: voltage; 5
V2: voltage; 5
V3: voltage; SINE(0 10m 10k)
V4: voltage; 12
V5: voltage; 5
V6: voltage; 5
V7: voltage; 12
V9: voltage; 12
V10: voltage; 12
V11: voltage; 5
V12: voltage; -5
Named nets: 0
.tran 0 100m
.include "specify_UA741.301_filepath_here"
