sudhu-joshi/audio-amp/simulations/gain.asc

C1: cap; 1µ
C2: cap; 0.1µ
Q1: npn; BC547B
rb1: res; 930k
rb2: res; 78k
rc: res; 8k
re: res; 90
V1: voltage; SINE(0 100m 1K)
V2: voltage; 5
V3: voltage; -5
Named nets: 0
.tran 20m
