sudhu-joshi/audio-amp/simulations/power amp.asc

C1: cap; 10µ
C2: cap; 10µ
D1: diode; 1N4148
D2: diode; 1N4148
Q1: npn; TIP31C
Q2: pnp; TIP32C
R1: res; 10
R2: res; {R}
R3: res; {R}
V1: voltage; 5
V2: voltage; -5
V3: voltage; SINE(0 5 1k)
Named nets: 0
.tran 10ms
.step param R 1k 100k 10k
