sudhu-joshi/audio-amp/simulations/pregain.asc

Q1: npn; BC547B
Q2: npn; BC547B
R1: res; 10k
R2: res; 10k
R3: res; 354
R4: res; 354
RT: res; 10k
V1: voltage; 5
V2: voltage; 5
V3: voltage; 1; AC 1
Named nets: 0
;.dc V3 -0.5 0.5 0.01
.tran 10m
